officiallyemma/UHF-RFID-Inventory-System/3d print/case.stl

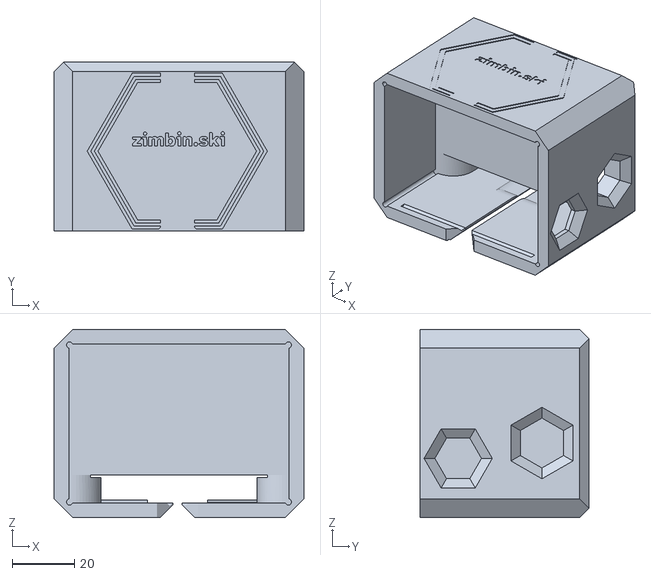
[picture p16: CAD file, 2026-10-25]
3d print/case.stl
80.1 x 54.0 x 60.3
