officiallyemma/UHF-RFID-Inventory-System/3d print/back lid.stl

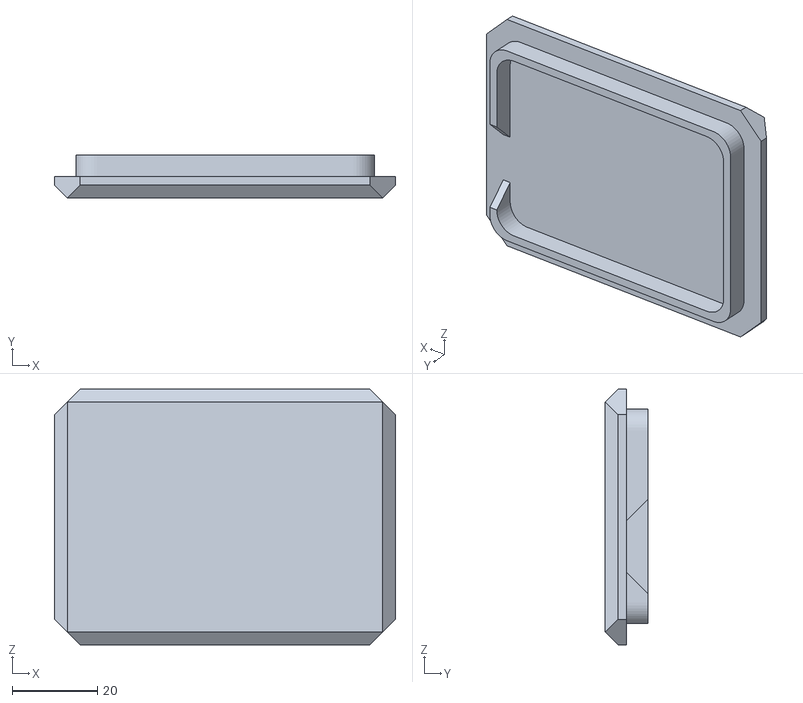
[picture p17: CAD file, 2026-10-25]
3d print/back lid.stl
80.0 x 10.0 x 60.0
