officiallyemma/UHF-RFID-Inventory-System/3d print/front lid.stl

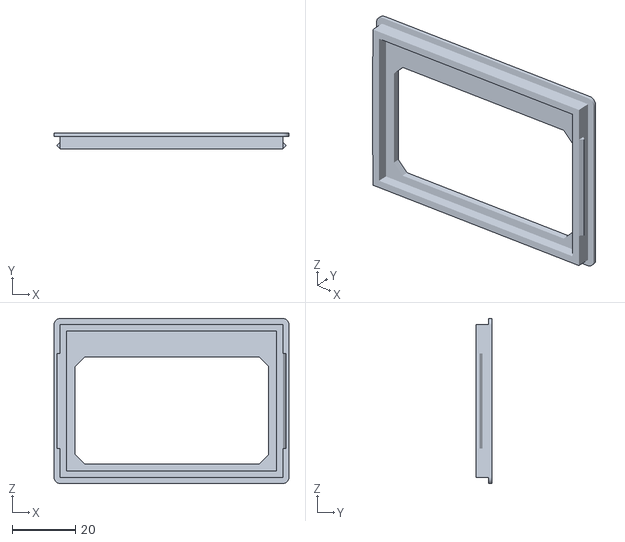
[picture p18: CAD file, 2026-10-25]
3d print/front lid.stl
74.4 x 5.00 x 52.3
