officiallyemma/UHF-RFID-Inventory-System/docs/images/reader debug/README.md

These files are provided under no warranty. I'm simply reuploading them here for visibility.

#### demo_V3.62_eng.rar

The RFID demo software itself

#### UHFDemo_v3.62_eng_source.rar

The source code for the RFID demo software

#### R300 communication interface protocol spec.pdf

A list of supported and unsupported commands, compared to YRM20 protocol

#### R300 UHF RFID module use Notes.pdf

A list of notes from the developers with regards to powering the chip

#### R300 UHF RFID reader module\*protocol\*.pdf

Documentation of the serial protocol. Note that some of these commands are unsupported, but still listed in this document.

#### UHF RFID Reader development Q&A.pdf

A few FAQ and more development notes.
