officiallyemma/UHF-RFID-Inventory-System/src/refactor/tag_config.cpp

#include "tag_config.h"

SavedTag savedTags[] = {{{0x79, 0xE7}, 2, "USB HUB"}, {{0x35, 0xE7}, 2, "MAC CHRG"}, {{0x69, 0xE7}, 2, "BADGE"},
                        {{0x75, 0xE7}, 2, "TRACER"},  {{0x71, 0xE7}, 2, "TONER"},    {{0x6D, 0xE7}, 2, "LABEL MKR"}};

//

const uint8_t maxSavedTags = 5;
